morsoth/Nivelador_Laser/Casing/Receptor Case.stl

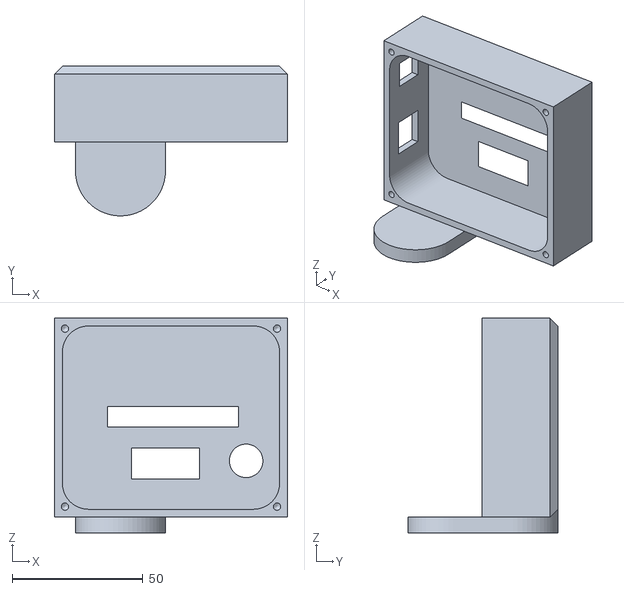
[picture p25: CAD file, 2025-01-29]
Casing/Receptor Case.stl
89.0 x 57.2 x 82.0
