morsoth/Nivelador_Laser/Casing/Receptor Back.stl

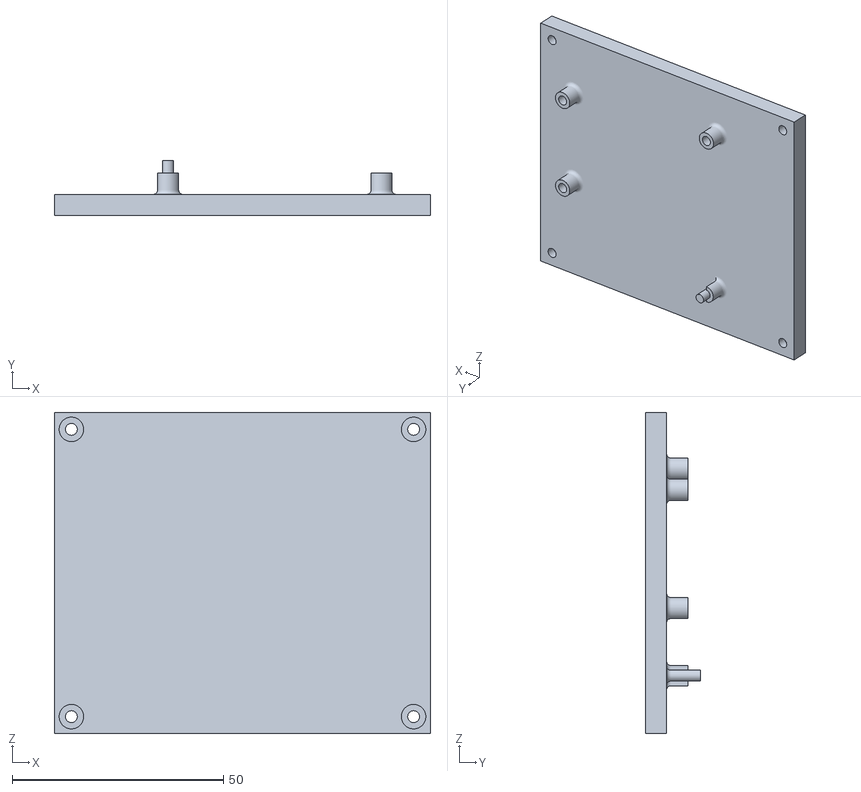
[picture p26: CAD file, 2025-01-29]
Casing/Receptor Back.stl
89.0 x 13.0 x 76.0
