morsoth/Nivelador_Laser/Casing/Rotator Axis.stl

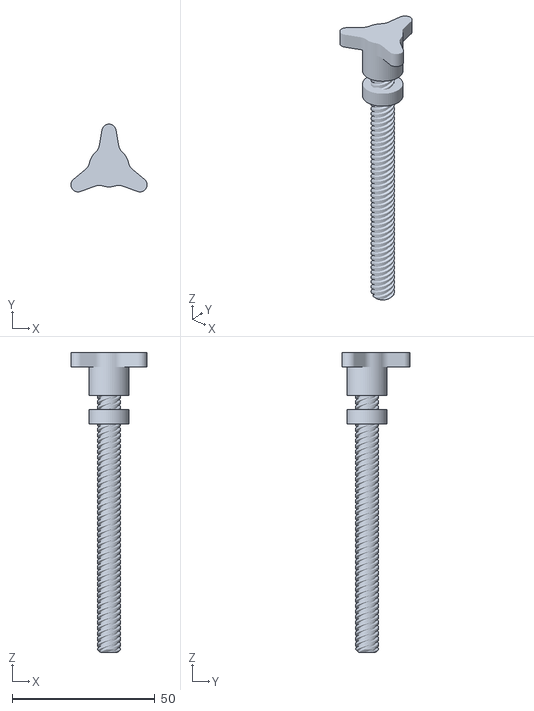
[picture p27: CAD file, 2025-01-29]
Casing/Rotator Axis.stl
26.7 x 23.7 x 105.0
