morsoth/Nivelador_Laser/Casing/Mobile Holder.stl

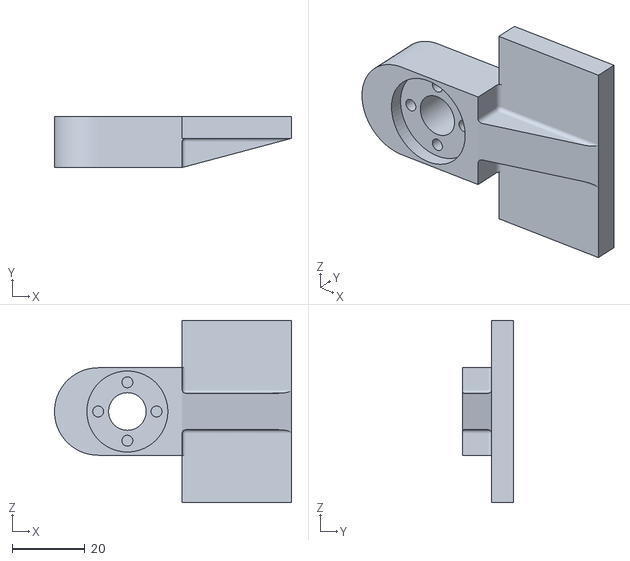
[picture p28: CAD file, 2025-01-29]
Casing/Mobile Holder.stl
65.0 x 14.0 x 50.0
