morsoth/Nivelador_Laser/Casing/Fixed Holder.stl

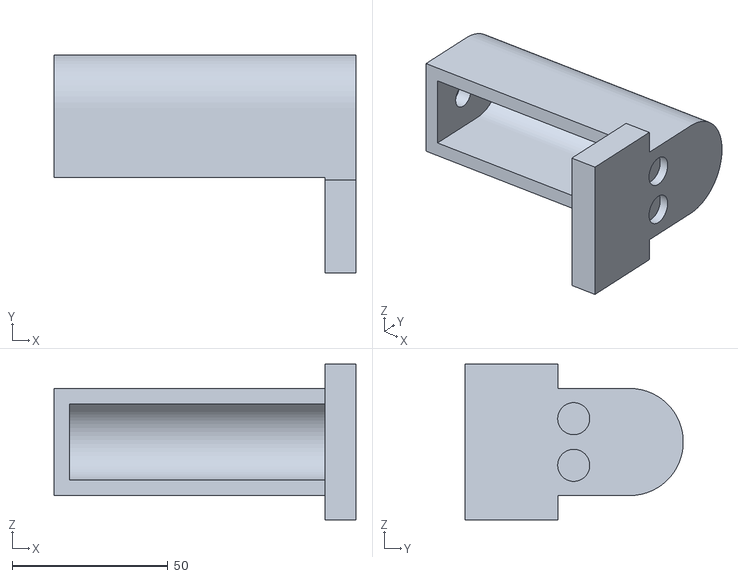
[picture p29: CAD file, 2025-01-29]
Casing/Fixed Holder.stl
97.0 x 70.2 x 50.0
