morsoth/Nivelador_Laser/PCBs/Receptor Laser/Receptor Laser.kicad_pcb

## KiCad design PCBs/Receptor Laser/Receptor Laser.kicad_pcb (2025-01-14)

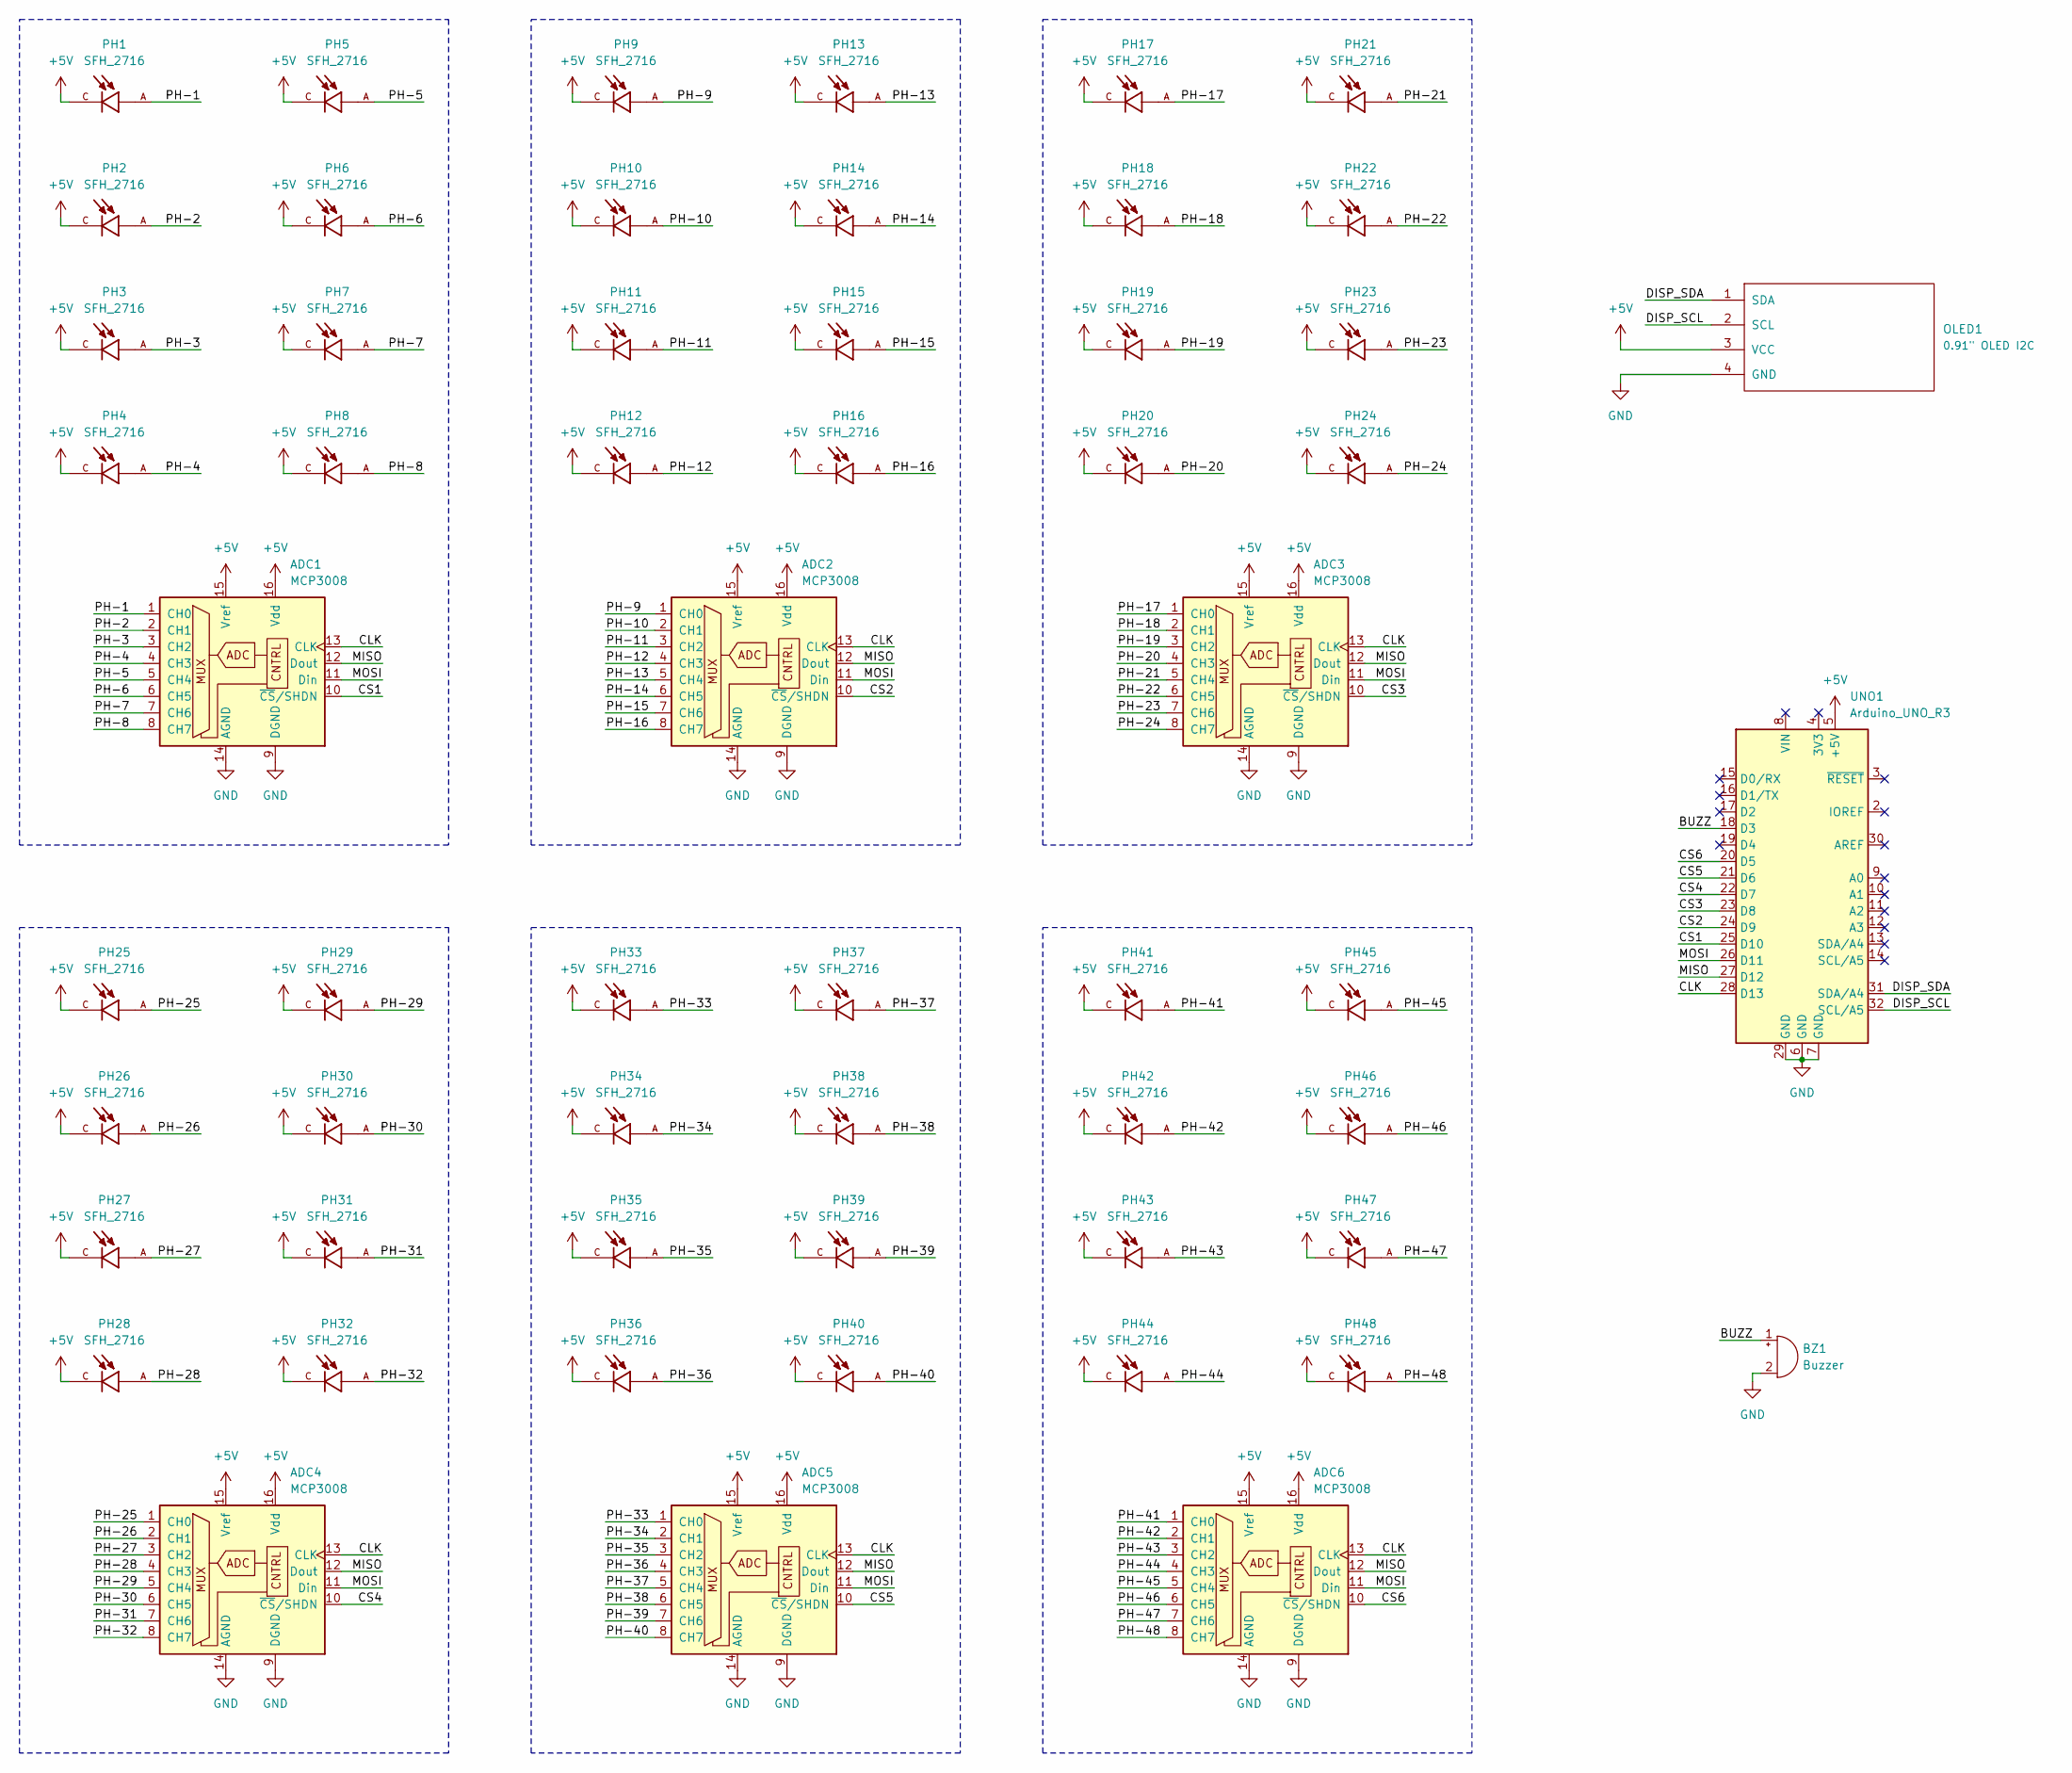
[picture p30: schematic Receptor Laser.kicad_sch]

Parts:
ADC1, ADC2, ADC3, ADC4, ADC5, ADC6: MCP3008; SOIC-16_3.9x9.9mm_P1.27mm
BZ1: Buzzer; Buzzer_12x9.5RM7.6
OLED1: 0.91" OLED I2C; OLED
PH1, PH2, PH3, PH4, PH5, PH6, PH7, PH8, PH9, PH10, PH11, PH12, PH13, PH14, PH15, PH16, PH17, PH18, PH19, PH20, PH21, PH22, PH23, PH24, PH25, PH26, PH27, PH28, PH29, PH30, PH31, PH32, PH33, PH34, PH35, PH36, PH37, PH38, PH39, PH40, PH41, PH42, PH43, PH44, PH45, PH46, PH47, PH48: SFH_2716; LEDC2012X100N; PARTREV 1.1
UNO1: Arduino_UNO_R3

Connections:
+5V: ADC1.15 (Vref), ADC1.16 (Vdd), ADC2.15 (Vref), ADC2.16 (Vdd), ADC3.15 (Vref), ADC3.16 (Vdd), ADC4.15 (Vref), ADC4.16 (Vdd), ADC5.15 (Vref), ADC5.16 (Vdd), ADC6.15 (Vref), ADC6.16 (Vdd), OLED1.3 (VCC), PH1.C, PH2.C, PH3.C, PH4.C, PH5.C, PH6.C, PH7.C, PH8.C, PH9.C, PH10.C, PH11.C, PH12.C, PH13.C, PH14.C, PH15.C, PH16.C, PH17.C, PH18.C, PH19.C, PH20.C, PH21.C, PH22.C, PH23.C, PH24.C, PH25.C, PH26.C, PH27.C, PH28.C, PH29.C, PH30.C, PH31.C, PH32.C, PH33.C, PH34.C, PH35.C, PH36.C, PH37.C, PH38.C, PH39.C, PH40.C, PH41.C, PH42.C, PH43.C, PH44.C, PH45.C, PH46.C, PH47.C, PH48.C, UNO1.5 (+5V)
/BUZZ: BZ1.1 (-), UNO1.18 (D3)
/CLK: ADC1.13 (CLK), ADC2.13 (CLK), ADC3.13 (CLK), ADC4.13 (CLK), ADC5.13 (CLK), ADC6.13 (CLK), UNO1.28 (D13)
/CS1: ADC1.10 (~CS/SHDN), UNO1.25 (D10)
/CS2: ADC2.10 (~CS/SHDN), UNO1.24 (D9)
/CS3: ADC3.10 (~CS/SHDN), UNO1.23 (D8)
/CS4: ADC4.10 (~CS/SHDN), UNO1.22 (D7)
/CS5: ADC5.10 (~CS/SHDN), UNO1.21 (D6)
/CS6: ADC6.10 (~CS/SHDN), UNO1.20 (D5)
/DISP_SCL: OLED1.2 (SCL), UNO1.32 (SCL/A5)
/DISP_SDA: OLED1.1 (SDA), UNO1.31 (SDA/A4)
/MISO: ADC1.12 (Dout), ADC2.12 (Dout), ADC3.12 (Dout), ADC4.12 (Dout), ADC5.12 (Dout), ADC6.12 (Dout), UNO1.27 (D12)
/MOSI: ADC1.11 (Din), ADC2.11 (Din), ADC3.11 (Din), ADC4.11 (Din), ADC5.11 (Din), ADC6.11 (Din), UNO1.26 (D11)
/PH-1: ADC1.1 (CH0), PH1.A
/PH-2: ADC1.2 (CH1), PH2.A
/PH-3: ADC1.3 (CH2), PH3.A
/PH-4: ADC1.4 (CH3), PH4.A
/PH-5: ADC1.5 (CH4), PH5.A
/PH-6: ADC1.6 (CH5), PH6.A
/PH-7: ADC1.7 (CH6), PH7.A
/PH-8: ADC1.8 (CH7), PH8.A
/PH-9: ADC2.1 (CH0), PH9.A
/PH-10: ADC2.2 (CH1), PH10.A
/PH-11: ADC2.3 (CH2), PH11.A
/PH-12: ADC2.4 (CH3), PH12.A
/PH-13: ADC2.5 (CH4), PH13.A
/PH-14: ADC2.6 (CH5), PH14.A
/PH-15: ADC2.7 (CH6), PH15.A
/PH-16: ADC2.8 (CH7), PH16.A
/PH-17: ADC3.1 (CH0), PH17.A
/PH-18: ADC3.2 (CH1), PH18.A
/PH-19: ADC3.3 (CH2), PH19.A
/PH-20: ADC3.4 (CH3), PH20.A
/PH-21: ADC3.5 (CH4), PH21.A
/PH-22: ADC3.6 (CH5), PH22.A
/PH-23: ADC3.7 (CH6), PH23.A
/PH-24: ADC3.8 (CH7), PH24.A
/PH-25: ADC4.1 (CH0), PH25.A
/PH-26: ADC4.2 (CH1), PH26.A
/PH-27: ADC4.3 (CH2), PH27.A
/PH-28: ADC4.4 (CH3), PH28.A
/PH-29: ADC4.5 (CH4), PH29.A
/PH-30: ADC4.6 (CH5), PH30.A
/PH-31: ADC4.7 (CH6), PH31.A
/PH-32: ADC4.8 (CH7), PH32.A
/PH-33: ADC5.1 (CH0), PH33.A
/PH-34: ADC5.2 (CH1), PH34.A
/PH-35: ADC5.3 (CH2), PH35.A
/PH-36: ADC5.4 (CH3), PH36.A
/PH-37: ADC5.5 (CH4), PH37.A
/PH-38: ADC5.6 (CH5), PH38.A
/PH-39: ADC5.7 (CH6), PH39.A
/PH-40: ADC5.8 (CH7), PH40.A
/PH-41: ADC6.1 (CH0), PH41.A
/PH-42: ADC6.2 (CH1), PH42.A
/PH-43: ADC6.3 (CH2), PH43.A
/PH-44: ADC6.4 (CH3), PH44.A
/PH-45: ADC6.5 (CH4), PH45.A
/PH-46: ADC6.6 (CH5), PH46.A
/PH-47: ADC6.7 (CH6), PH47.A
/PH-48: ADC6.8 (CH7), PH48.A
GND: ADC1.9 (DGND), ADC1.14 (AGND), ADC2.9 (DGND), ADC2.14 (AGND), ADC3.9 (DGND), ADC3.14 (AGND), ADC4.9 (DGND), ADC4.14 (AGND), ADC5.9 (DGND), ADC5.14 (AGND), ADC6.9 (DGND), ADC6.14 (AGND), BZ1.2 (+), OLED1.4 (GND), UNO1.6 (GND), UNO1.7 (GND), UNO1.29 (GND)

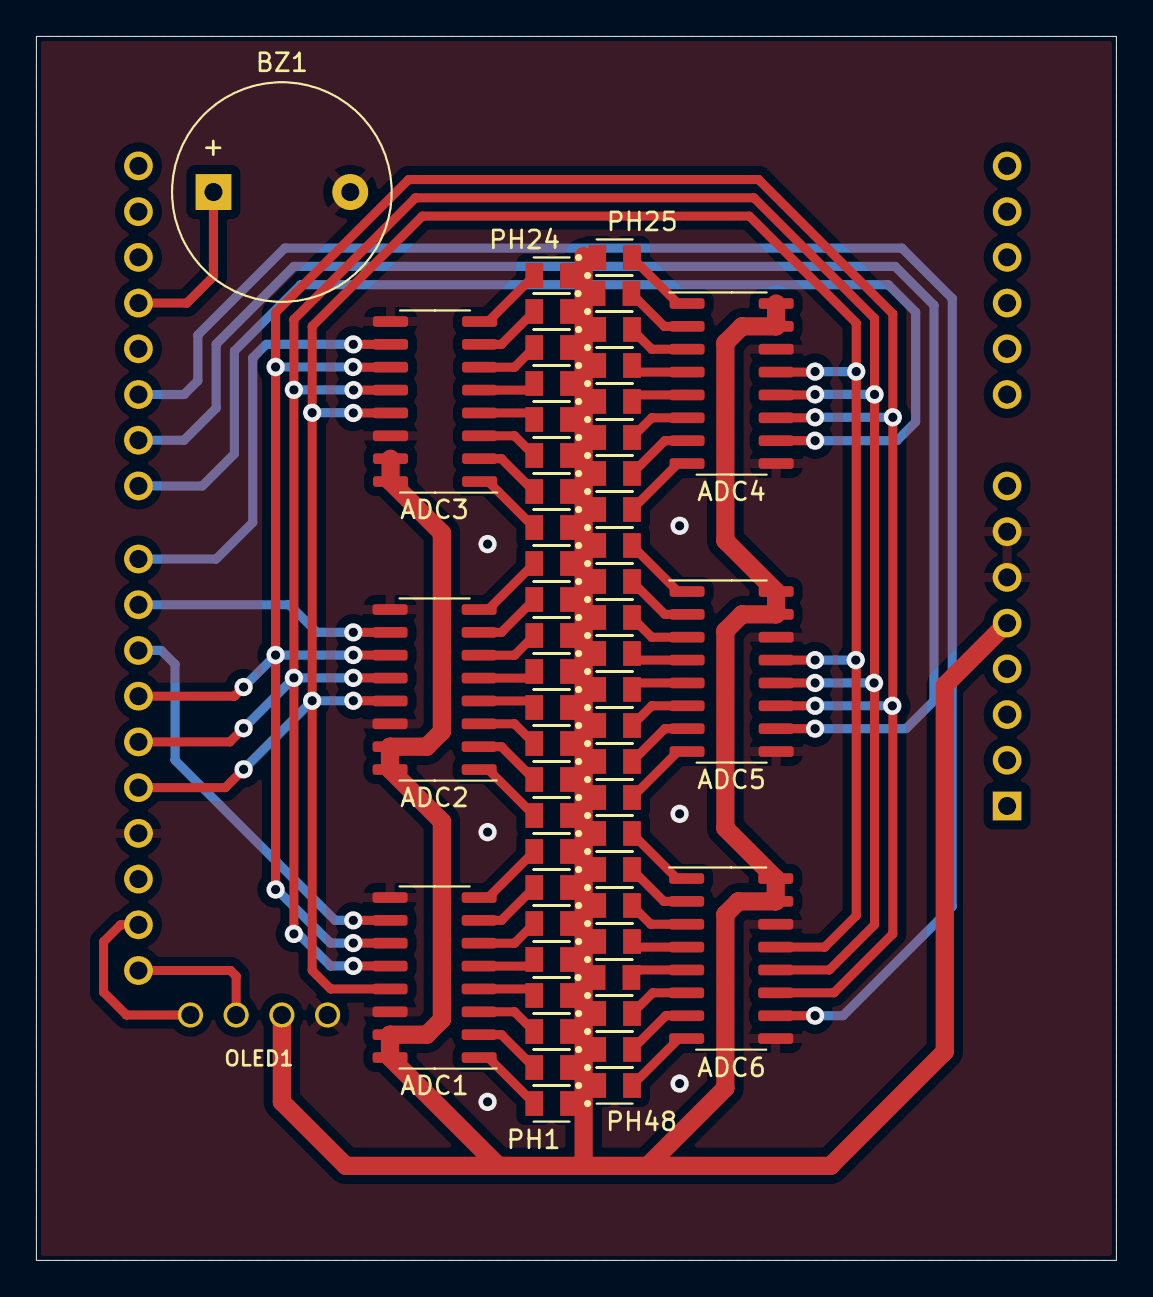
[picture p31: board Receptor Laser.kicad_pcb from above]

Board: 2 copper layers, 60.0 x 68.0 mm, 57 parts (1 on the bottom side), 62 nets.
