morsoth/Nivelador_Laser/PCBs/Nivelador Laser/Nivelador Laser.kicad_pcb

## KiCad design PCBs/Nivelador Laser/Nivelador Laser.kicad_pcb (2025-01-14)

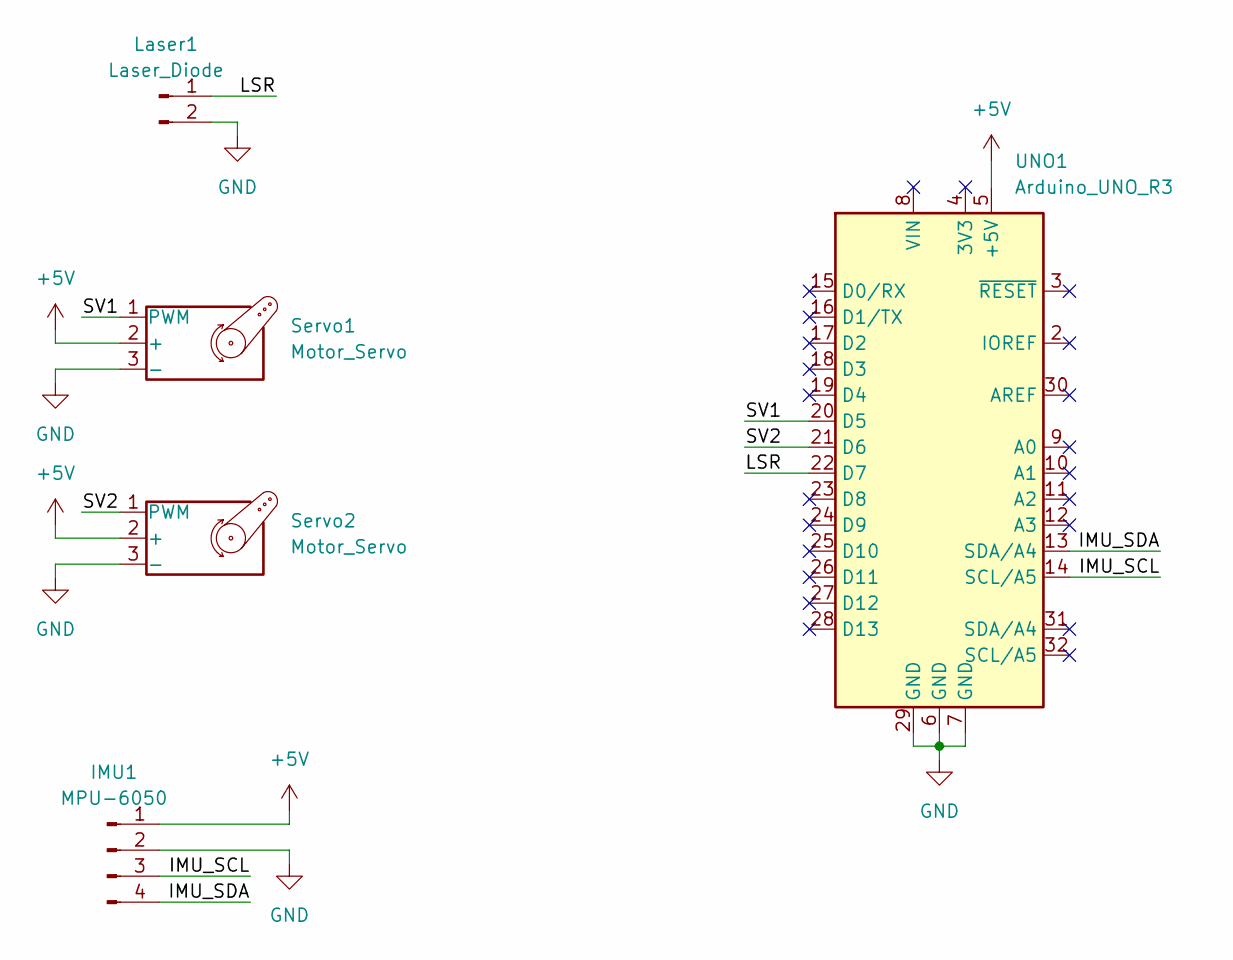
[picture p32: schematic Nivelador Laser.kicad_sch]

Parts:
IMU1: MPU-6050; PinSocket_1x04_P2.54mm_Vertical
Laser1: Laser_Diode; SolderWire-0.5sqmm_1x02_P4.6mm_D0.9mm_OD2.1mm_Relief
Servo1, Servo2: Motor_Servo; PinHeader_1x03_P2.54mm_Vertical
UNO1: Arduino_UNO_R3

Connections:
+5V: IMU1.1, Servo1.2 (+), Servo2.2 (+), UNO1.5 (+5V)
/IMU_SCL: IMU1.3, UNO1.14 (SCL/A5)
/IMU_SDA: IMU1.4, UNO1.13 (SDA/A4)
/LSR: Laser1.1, UNO1.22 (D7)
/SV1: Servo1.1 (PWM), UNO1.20 (D5)
/SV2: Servo2.1 (PWM), UNO1.21 (D6)
GND: IMU1.2, Laser1.2, Servo1.3 (-), Servo2.3 (-), UNO1.6 (GND), UNO1.7 (GND), UNO1.29 (GND)

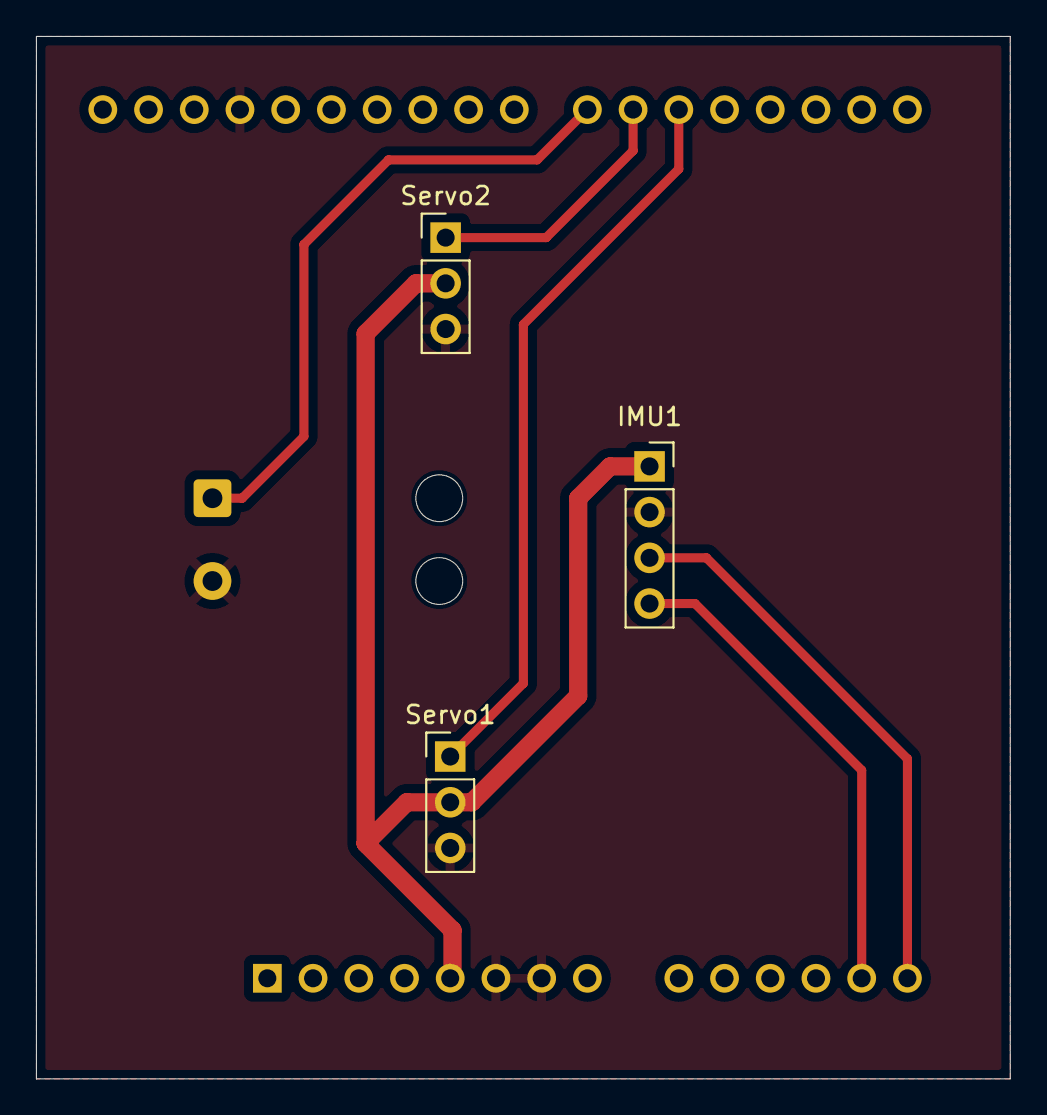
[picture p33: board Nivelador Laser.kicad_pcb from above]

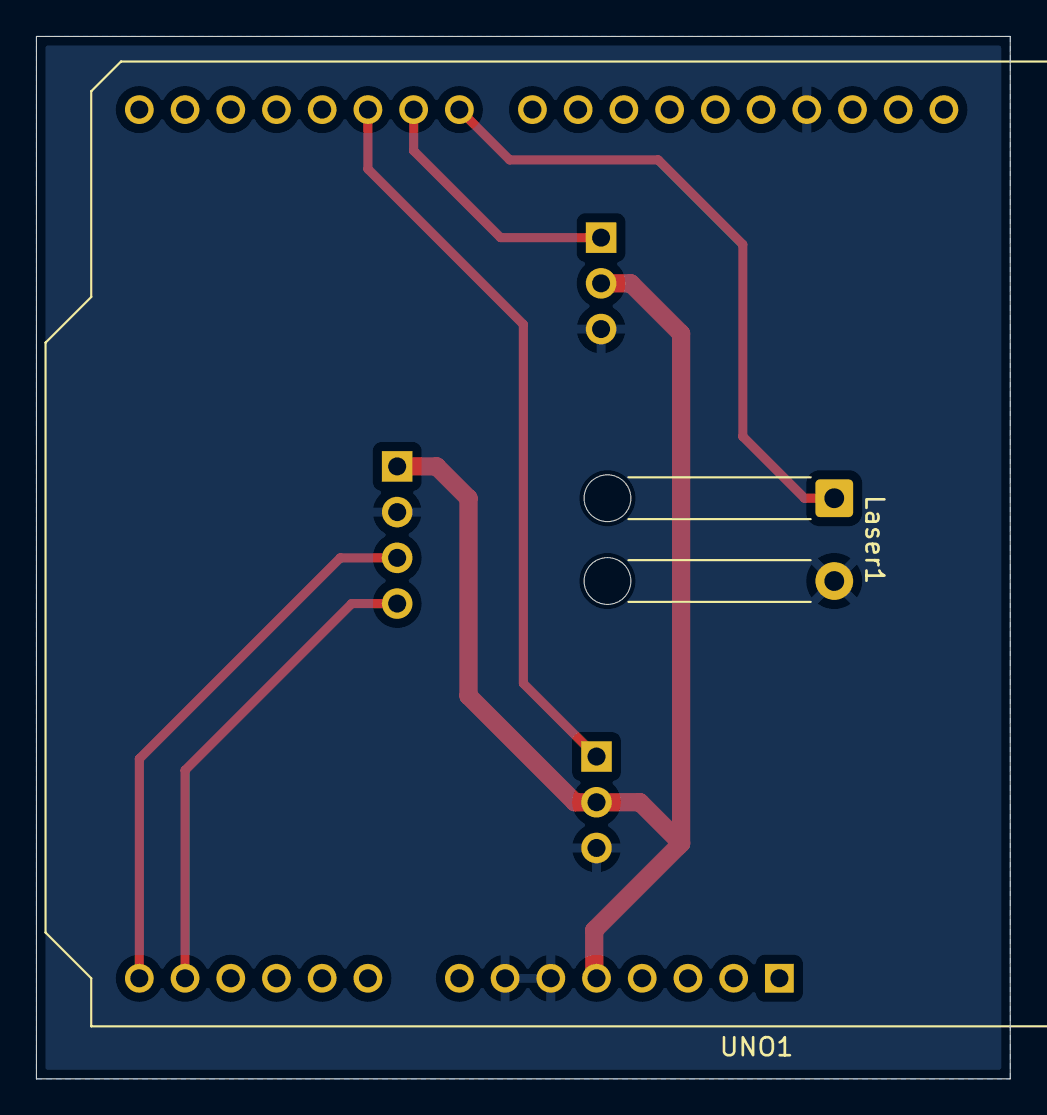
[picture p34: board Nivelador Laser.kicad_pcb from below]

Board: 2 copper layers, 54.1 x 57.9 mm, 5 parts (2 on the bottom side), 7 nets.
