morsoth/Nivelador_Laser/(commit log)

2024-12-07 kicad files added
    [Nivelador Laser.kicad_pcb, Nivelador Laser.kicad_sch]
2024-12-07 added laser reciever
    [Nivelador Laser.kicad_pcb, Receptor Laser.kicad_pcb, Receptor Laser.kicad_sch]
2024-12-07 added local cad libs
2024-12-07 added sumbols and footprints subfolders
2024-12-07 gitignore kicad
2025-01-08 pcb receptor
    [Receptor Laser.kicad_pcb, Receptor Laser.kicad_sch]
2025-01-14 ignore .kicad_sch-bak
